saghya/passwordManager/Hardware/passwordManager.pdf

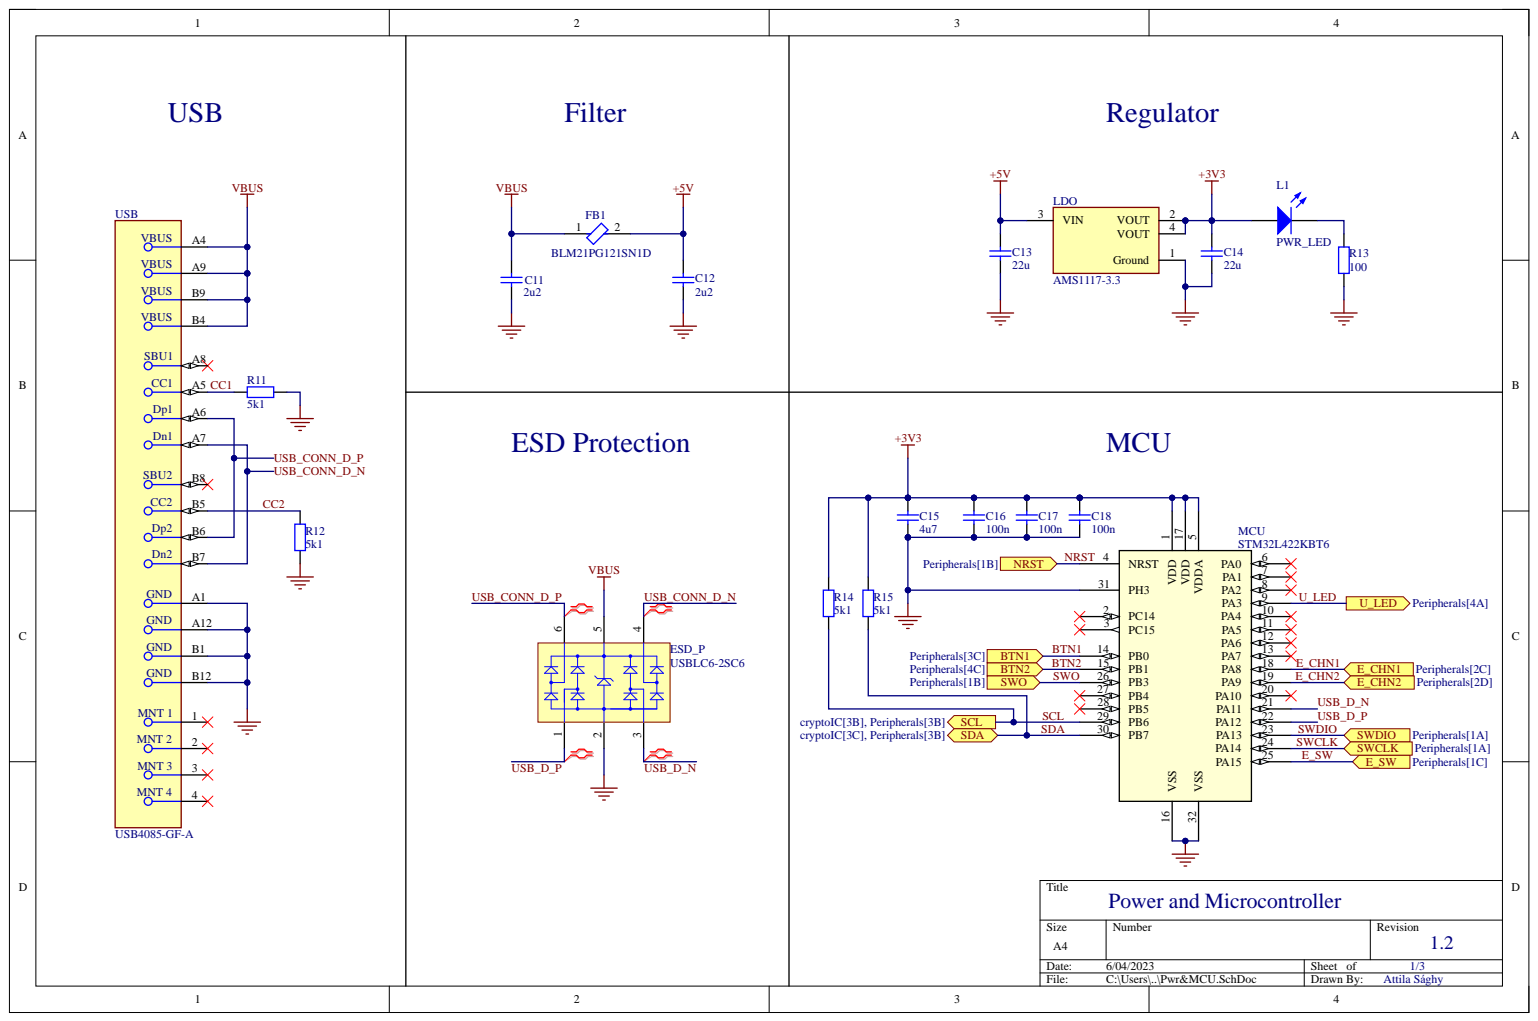
[picture p17: page 1]

Peripherals[3C] BTN1 Peripherals[4C] BTN2 Peripherals[1B] SWO

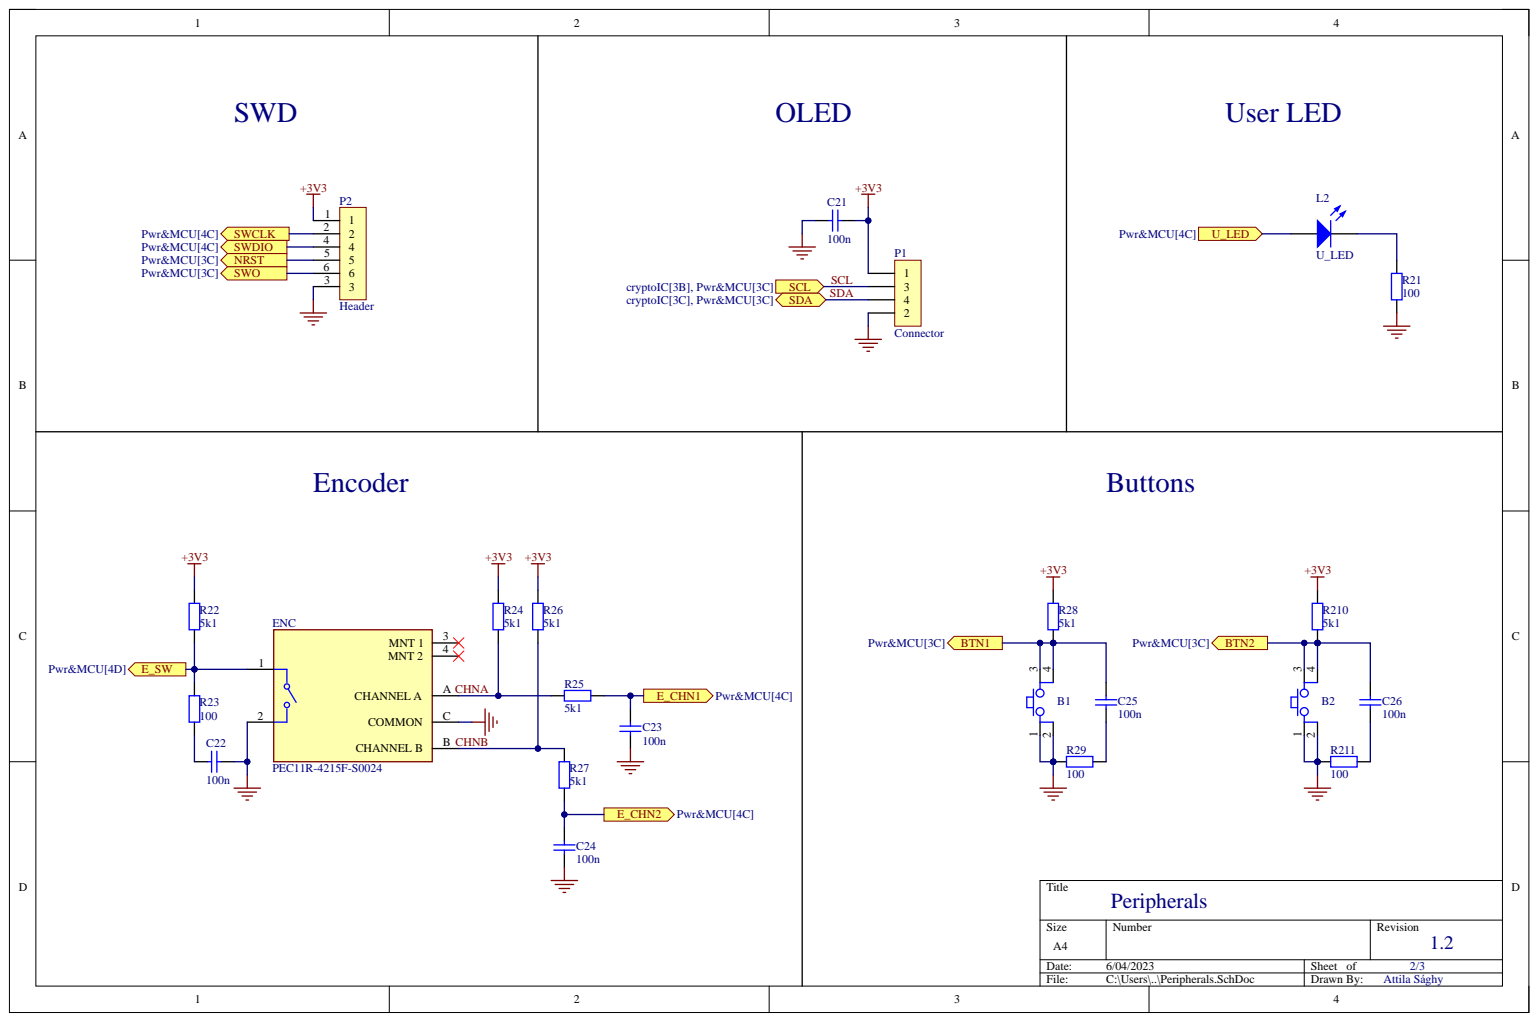
[picture p18: page 2]

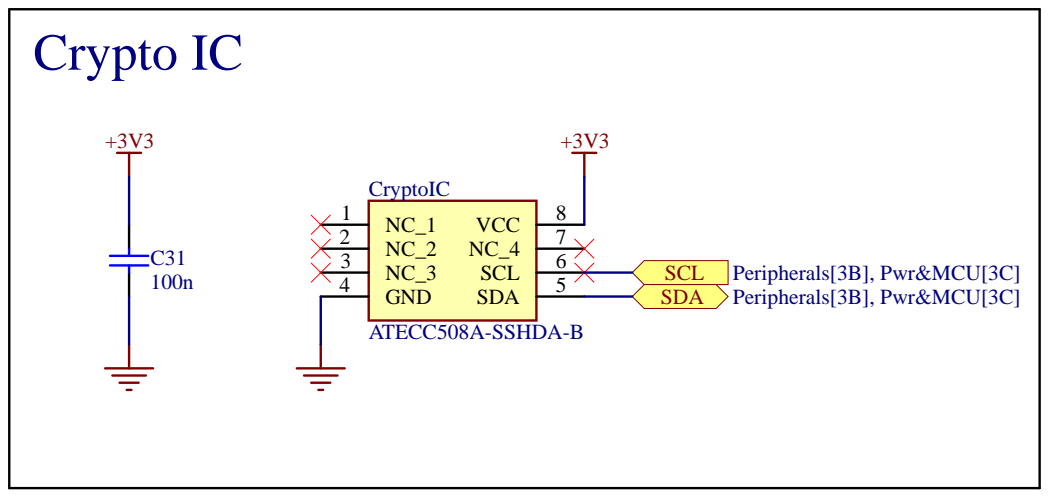
[picture p19: page 3]
