saghya/passwordManager/(list of files, drawings)

Other design files:
Hardware/cryptoIC.SchDoc
Hardware/hallglib.SchLib
Hardware/mylib.SchLib
Hardware/MySch.SchLib
Hardware/passwordManager.PcbDoc
Hardware/passwordManager.PrjPcb
Hardware/Peripherals.SchDoc
Hardware/Pwr&MCU.SchDoc
Hardware/STM32L422KBT6.PcbLib
Hardware/STM32L422KBT6.SchLib
