saghya/passwordManager/Firmware/Core/Src/main.c

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
/* Includes ------------------------------------------------------------------*/
#include "main.h"
#include "led.h"
#include "stm32l4xx_hal_flash.h"
#include "stm32l4xx_hal_rng.h"
#include "usb_device.h"

/* USER CODE BEGIN Includes */
#include <stdlib.h>
#include "ssd1306.h"
#include "pin.h"
#include "menu.h"
/* USER CODE END Includes */

I2C_HandleTypeDef hi2c1;

RNG_HandleTypeDef hrng;

TIM_HandleTypeDef htim1;
TIM_HandleTypeDef htim15;
TIM_HandleTypeDef htim16;

void        SystemClock_Config(void);
static void MX_GPIO_Init(void);
static void MX_I2C1_Init(void);
static void MX_RNG_Init(void);
static void MX_TIM1_Init(void);
static void MX_TIM15_Init(void);
static void MX_TIM16_Init(void);
/**
 * @brief  The application entry point.
 * @retval int
 */
int main(void)
{
    /* MCU
     * Configuration--------------------------------------------------------*/

    /* Reset of all peripherals, Initializes the Flash interface and the
     * Systick. */
    HAL_Init();

    /* Configure the system clock */
    SystemClock_Config();

    /* Initialize all configured peripherals */
    MX_GPIO_Init();
    MX_I2C1_Init();
    MX_RNG_Init();
    MX_USB_DEVICE_Init();
    MX_TIM1_Init();
    MX_TIM15_Init();
    MX_TIM16_Init();
    /* USER CODE BEGIN 2 */

    HAL_TIM_Encoder_Start(&htim1, TIM_CHANNEL_ALL); // encoder: TIM1->CNT
    HAL_TIM_PWM_Start(&htim15, TIM_CHANNEL_2);      // green led: TIM15->CCR2
    HAL_TIM_Base_Start_IT(&htim16);
    ssd1306_Init(); // initialize the display
    LED_Off();

    /* USER CODE END 2 */

    /* Infinite loop */
    /* USER CODE BEGIN WHILE */
    while (1) {
        MainMenu_Loop();
        /* USER CODE END WHILE */

        /* USER CODE BEGIN 3 */
    }
    /* USER CODE END 3 */
}

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
/* USER CODE BEGIN 4 */

void HAL_TIM_PeriodElapsedCallback(TIM_HandleTypeDef *htim)
{
    if (htim == &htim16) { // lock after 32s
        lock();
    }
}

/* USER CODE END 4 */
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
