saghya/passwordManager/Firmware/Core/Src/encoder.c

#include <stdlib.h>
#include "encoder.h"
#include "pin.h"

static int16_t prev_enc = 0;

int8_t encoderDelta()
{
    int8_t retval = 0;
    if (abs(ENC_CNT - prev_enc) > 3) {
        AUTOLOCK_TIMER = 0; // reset idle
        retval   = (ENC_CNT - prev_enc < 0) ? -1 : +1;
        prev_enc = ENC_CNT;
    }
    return retval;
}
